botterillneurolab/StereoPylot/Build_Setup_Files/Wiring/PCB board schematic.pdf

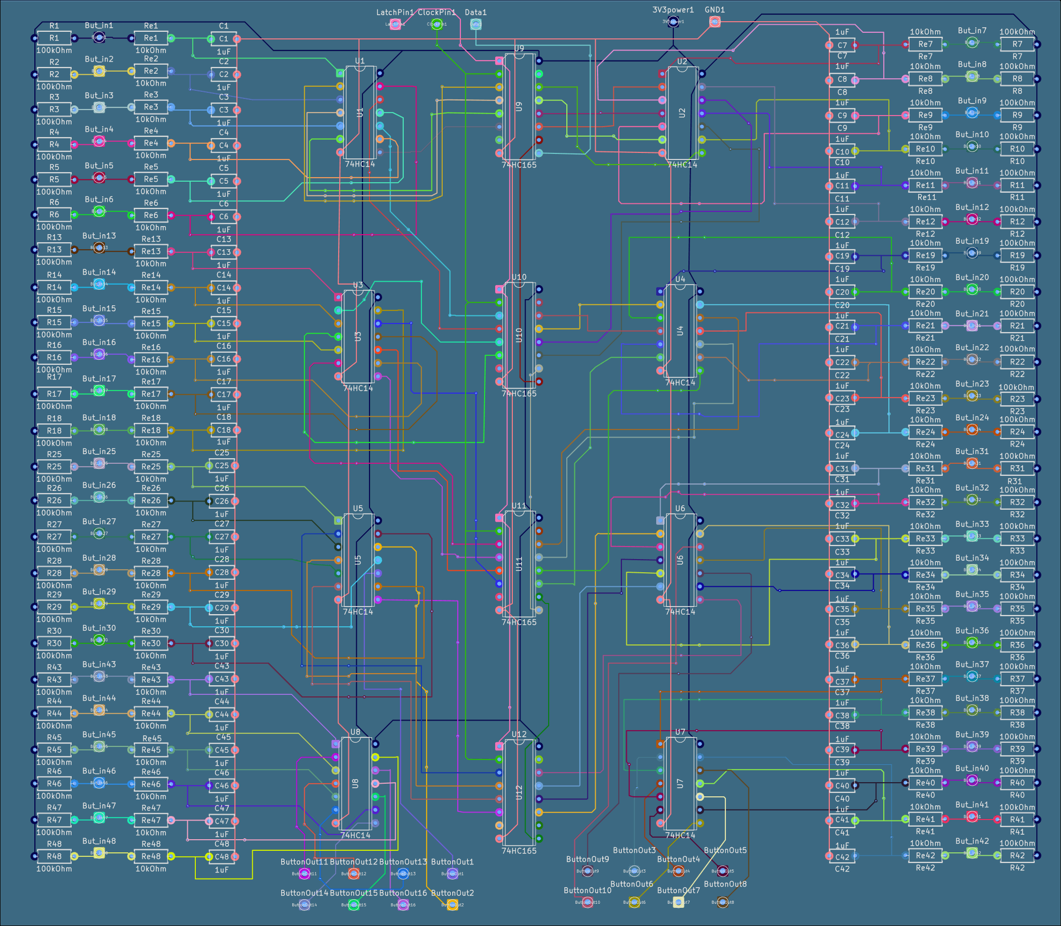
[picture p1: page 1]
