botterillneurolab/StereoPylot/Build_Setup_Files/3D_models/3d_Printing_STEP/37mm_Motor_Mount_Left.step

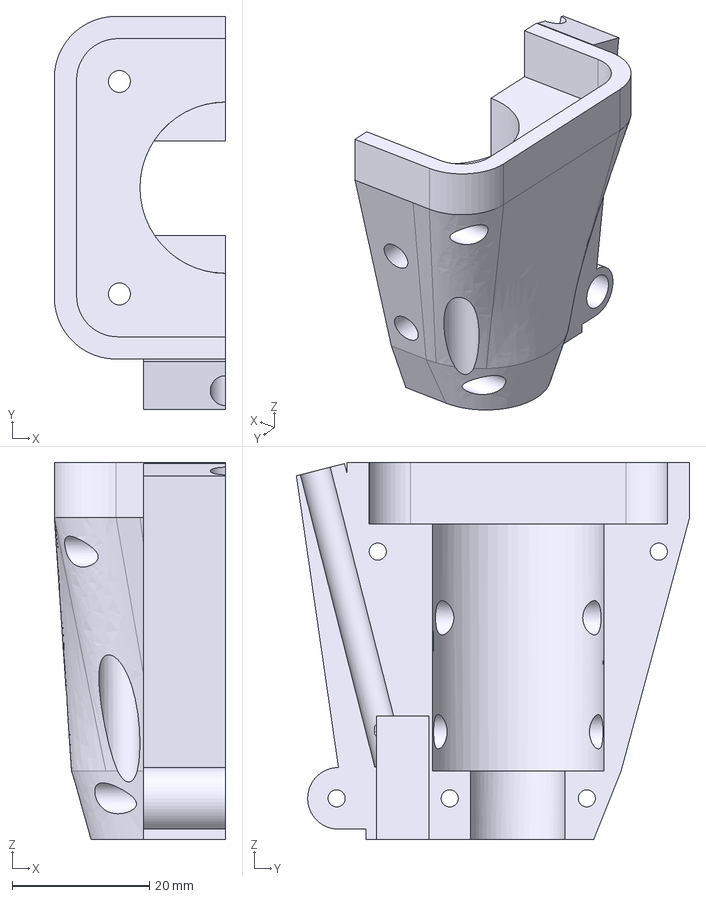
[picture p2: CAD file, 2026-03-18]
Build_Setup_Files/3D_models/3d_Printing_STEP/37mm_Motor_Mount_Left.step
25.0 x 57.4 x 55.0 mm
