botterillneurolab/StereoPylot/Build_Setup_Files/3D_models/3d_Printing_STEP/Control_Box_Upper_Face.step

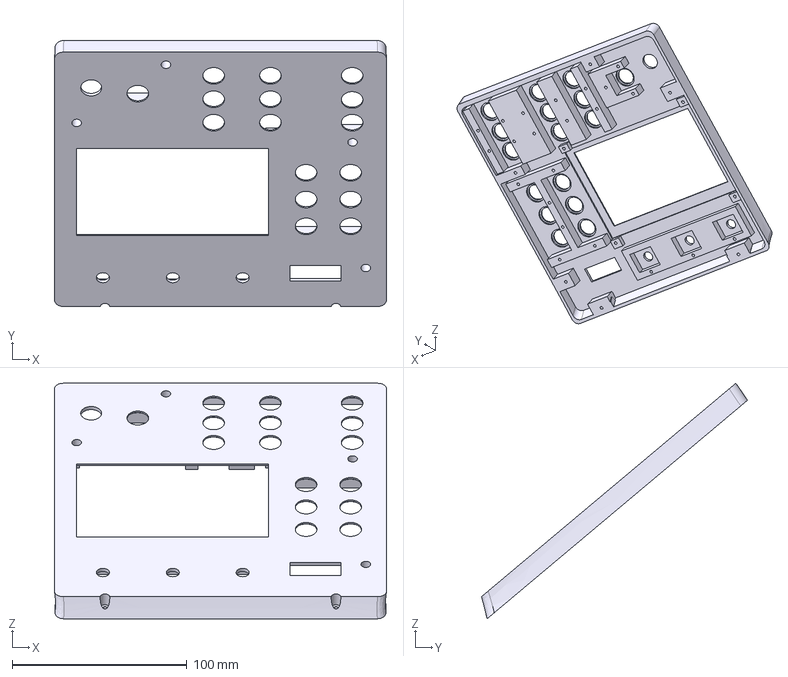
[picture p3: CAD file, 2026-03-18]
Build_Setup_Files/3D_models/3d_Printing_STEP/Control_Box_Upper_Face.step
190.0 x 152.2 x 134.8 mm
