botterillneurolab/StereoPylot/Build_Setup_Files/3D_models/3d_Printing_STEP/Control_Box_Cableholder.step

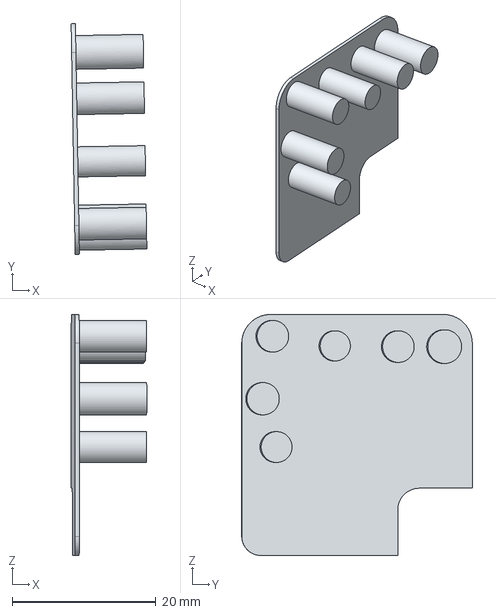
[picture p4: CAD file, 2026-03-18]
Build_Setup_Files/3D_models/3d_Printing_STEP/Control_Box_Cableholder.step
10.5 x 32.1 x 33.5 mm
