botterillneurolab/StereoPylot/Build_Setup_Files/3D_models/3d_Printing_STEP/Control_Box_Mid_Box.step

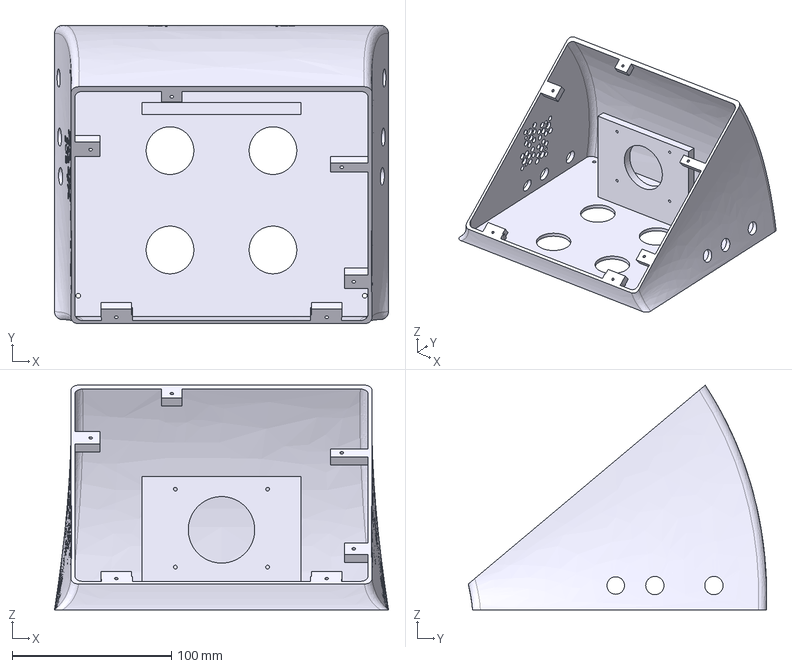
[picture p5: CAD file, 2026-03-18]
Build_Setup_Files/3D_models/3d_Printing_STEP/Control_Box_Mid_Box.step
210.0 x 187.6 x 141.3 mm
