botterillneurolab/StereoPylot/Build_Setup_Files/3D_models/3d_Printing_STEP/Control_Box_Lower_Box.step

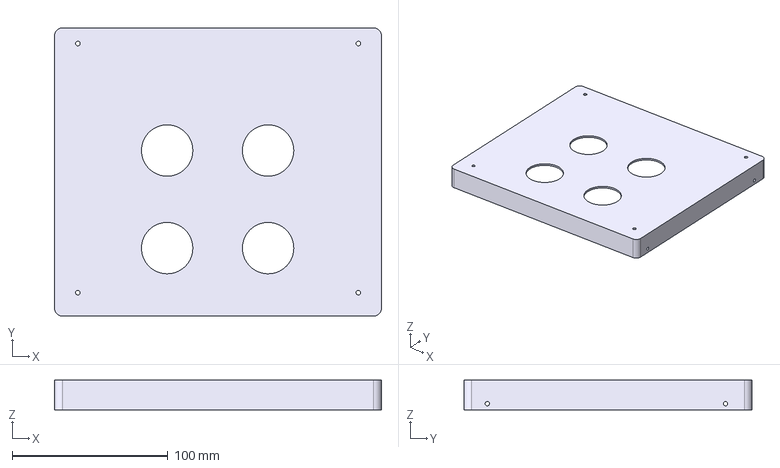
[picture p6: CAD file, 2026-03-18]
Build_Setup_Files/3D_models/3d_Printing_STEP/Control_Box_Lower_Box.step
210.0 x 185.0 x 19.0 mm
