botterillneurolab/StereoPylot/Build_Setup_Files/3D_models/3d_Printing_STEP/Control_Box_Base_Cover.step

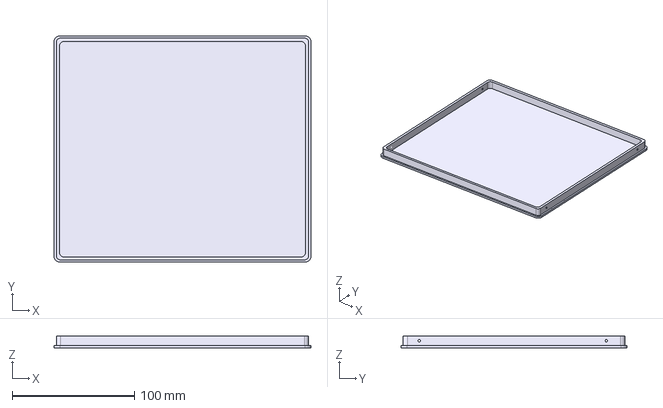
[picture p7: CAD file, 2026-03-18]
Build_Setup_Files/3D_models/3d_Printing_STEP/Control_Box_Base_Cover.step
210.0 x 185.0 x 10.0 mm
