botterillneurolab/StereoPylot/Build_Setup_Files/3D_models/3d_Printing_STEP/Motor_Mount_Rear.step

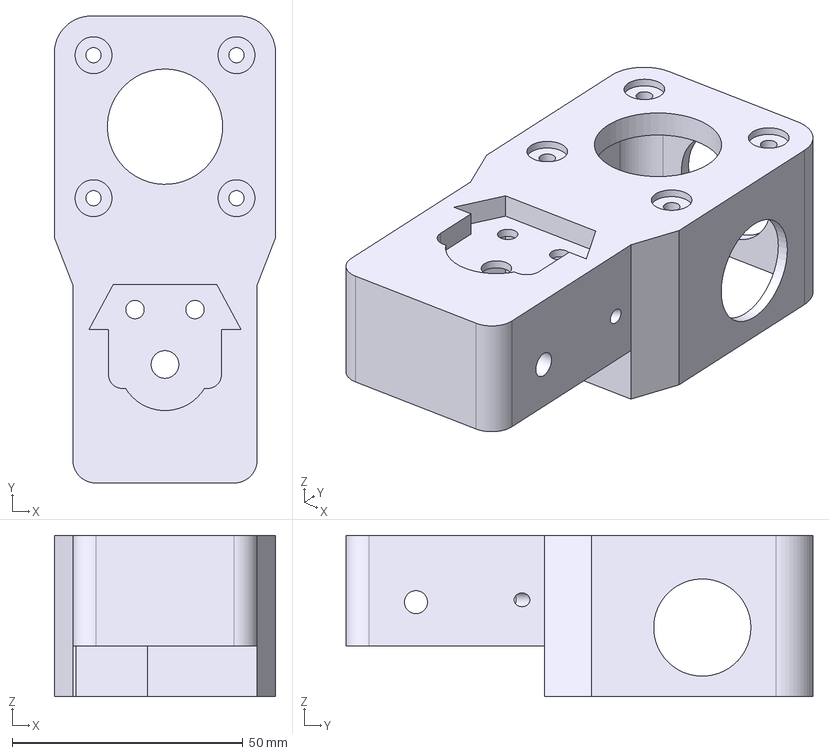
[picture p8: CAD file, 2026-03-18]
Build_Setup_Files/3D_models/3d_Printing_STEP/Motor_Mount_Rear.step
48.0 x 101.2 x 35.0 mm
