botterillneurolab/StereoPylot/Build_Setup_Files/3D_models/3d_Printing_STEP/Tapping_Guide.step

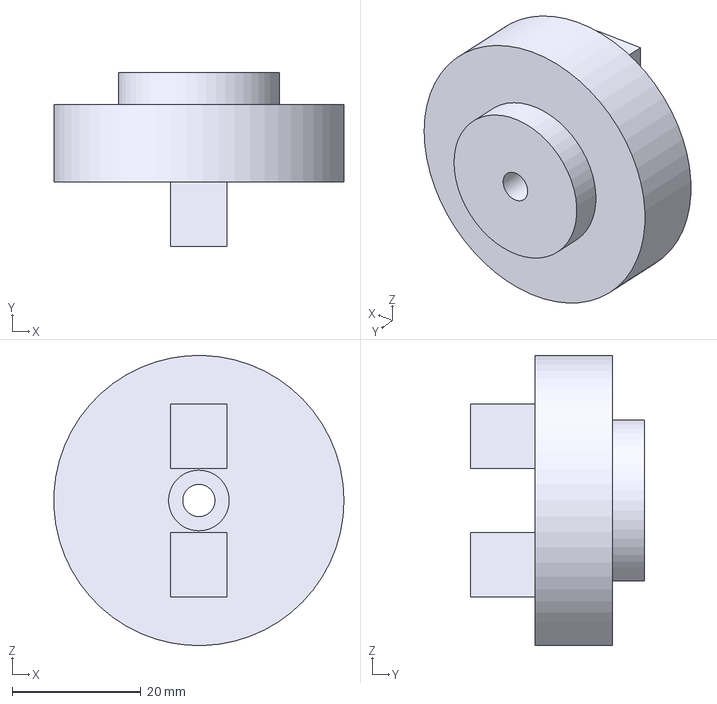
[picture p9: CAD file, 2025-12-02]
Build_Setup_Files/3D_models/3d_Printing_STEP/Tapping_Guide.step
45.0 x 27.0 x 45.0 mm
