botterillneurolab/StereoPylot/(list of files, cad)

Other CAD files:
Build_Setup_Files/3D_models/3d_Printing_STEP/33mm_Motor_Mount_Right.step
Build_Setup_Files/3D_models/3d_Printing_STEP/37mm_Motor_Mount_Right.step
Build_Setup_Files/3D_models/3d_Printing_STEP/33mm_Motor_Mount_Left.step
Build_Setup_Files/3D_models/3d_Printing_STEP/36mm_Motor_Mount_Left.step
Build_Setup_Files/3D_models/3d_Printing_STEP/36mm_Motor_Mount_Right.step
Build_Setup_Files/3D_models/3d_Printing_STEP/Control_Box_Face.step
Build_Setup_Files/3D_models/3d_Printing_STEP/Control_Box_lower.step
Build_Setup_Files/3D_models/3d_Printing_STLs/33mm_Motor_Mount_Left.stl
Build_Setup_Files/3D_models/3d_Printing_STLs/33mm_Motor_Mount_Right.stl
Build_Setup_Files/3D_models/3d_Printing_STLs/36mm_Motor_Mount_Left.stl
Build_Setup_Files/3D_models/3d_Printing_STLs/36mm_Motor_Mount_Right.stl
Build_Setup_Files/3D_models/3d_Printing_STLs/37mm_Motor_Mount_Left.stl
Build_Setup_Files/3D_models/3d_Printing_STLs/37mm_Motor_Mount_Right.stl
Build_Setup_Files/3D_models/3d_Printing_STLs/Control_Box_Base_Cover.stl
Build_Setup_Files/3D_models/3d_Printing_STLs/Control_Box_Cableholder.stl
Build_Setup_Files/3D_models/3d_Printing_STLs/Control_Box_Lower_Box.stl
Build_Setup_Files/3D_models/3d_Printing_STLs/Control_Box_Mid_Box.stl
Build_Setup_Files/3D_models/3d_Printing_STLs/Control_Box_Upper_Face.stl
Build_Setup_Files/3D_models/3d_Printing_STLs/Motor_Mount_Rear.stl
Build_Setup_Files/3D_models/3d_Printing_STLs/Tapping_Guide.stl
