botterillneurolab/StereoPylot/Build_Setup_Files/Button_Overlay/Button_Overlay.pdf

## Emergency

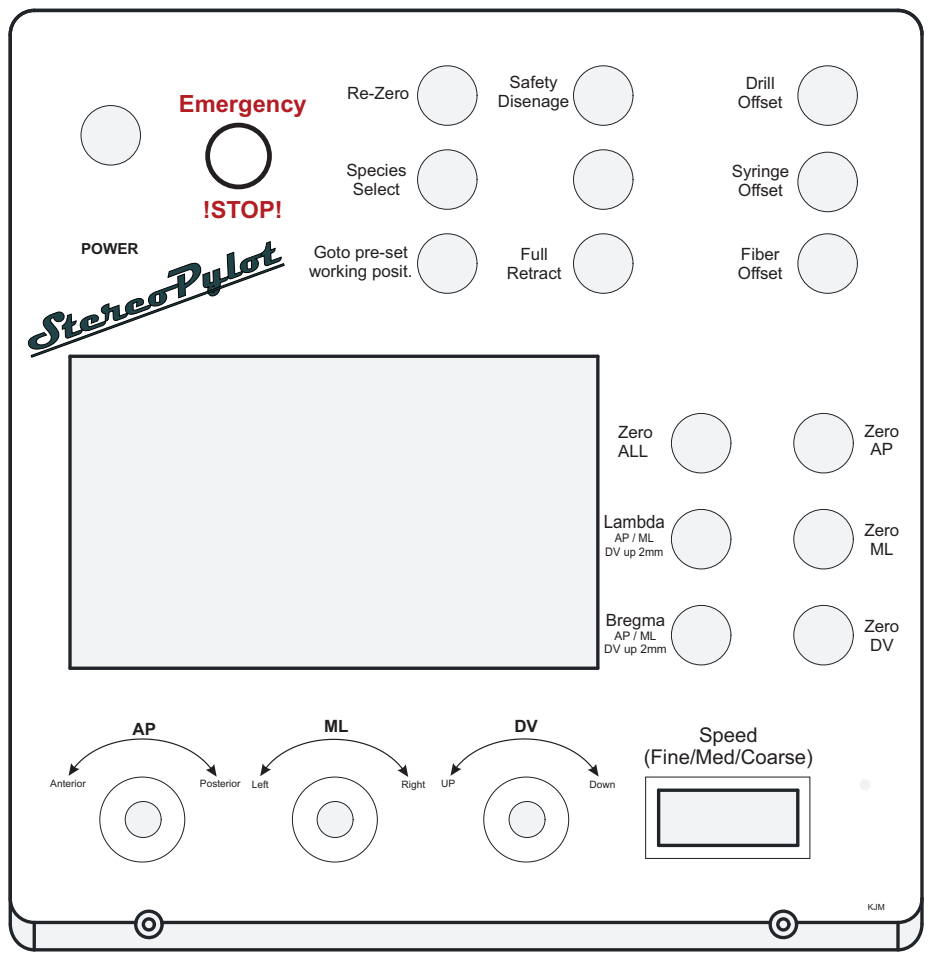
[picture p10: page 1]
!STOP!; Re-Zero; Full Retract; Drill Offset; Syringe Offset; Fiber Offset; Zero AP; Zero ML; Zero DV; Zero ALL; Bregma; Lambda; Left; Right; Anterior; Posterior; Down; Speed; KJM; Safety Disenage; Species Select; StereoPylot POWER

Goto pre-set
working posit.

(Fine/Med/Coarse)
