botterillneurolab/StereoPylot/Build_Setup_Files/Wiring/RaspberryPinLayout.xlsx

Raspberry PI Pin Layout
 | SD Card Slot
Connection | GPIO | Pin Number | Pin Number | GPIO | Connection
Button board / Encoder board | 3v3 | 1 | 2 | 5v | stepper 5V
Enable ALL | 2 | 3 | 4 | 5v
dir AP | 3 | 5 | 6 | GND | stepper GND
step AP | 4 | 7 | 8 | 14
 | GND | 9 | 10 | 15
dir ML | 17 | 11 | 12 | 18 | LatchPin
step ML | 27 | 13 | 14 | GND | Button board GND
limit AP | 22 | 15 | 16 | 23 | ClockPin
 | 3v3 | 17 | 18 | 24 | DataPin
misc_butA | 10 | 19 | 20 | GND | Limit GND
 | 9 | 21 | 22 | 25 | rotoAP_A
misc_butB | 11 | 23 | 24 | 8 | rotoAP_B
Button board GND | GND | 25 | 26 | 7
 | 0 | 27 | 28 | 1
dir DV | 5 | 29 | 30 | GND
step DV | 6 | 31 | 32 | 12 | rotoML_A
limit ML | 13 | 33 | 34 | GND
limit DV | 19 | 35 | 36 | 16 | rotoML_B
EMERG STOP | 26 | 37 | 38 | 20 | rotoDV_A
Encoder Board GND | GND | 39 | 40 | 21 | rotoDV_B
