botterillneurolab/StereoPylot/Build_Setup_Files/Wiring/Wiring Diagram.pdf

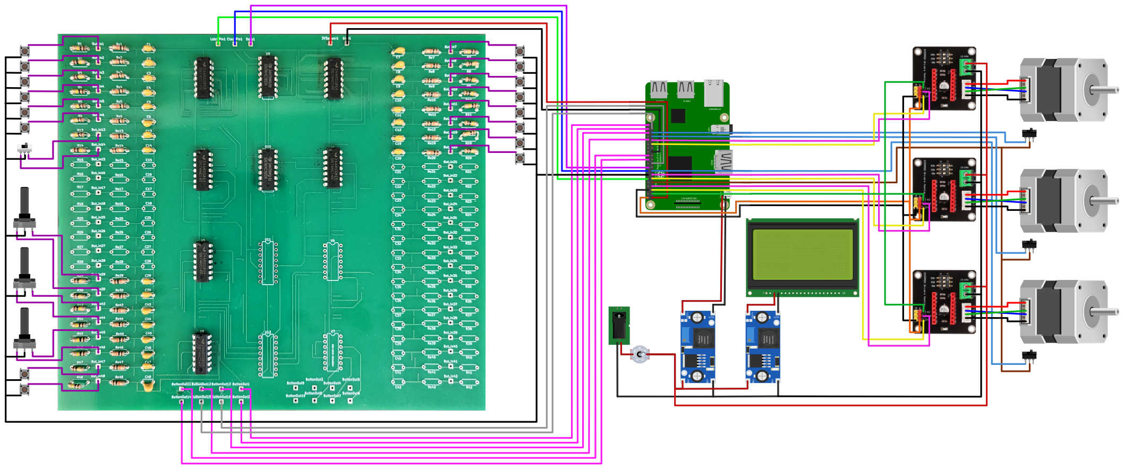
[picture p11: page 1]
