botterillneurolab/StereoPylot/(commit log)

2025-12-02 Initial upload of files
    [33mm_Motor_Mount_Left.step, 33mm_Motor_Mount_Left.stl, 33mm_Motor_Mount_Right.step, 33mm_Motor_Mount_Right.stl, 36mm_Motor_Mount_Left.step, 36mm_Motor_Mount_Left.stl, 36mm_Motor_Mount_Right.step, 36mm_Motor_Mount_Right.stl]
2025-12-08 Code fix
    Corrected direction movement difference between LH and RH sides.
    [StereotaxicUI.py]
2026-03-18 Delete Build_Setup_Files/3D_models/3d_Printing_STEP directory
    Deleting directory for restructuring
    [33mm_Motor_Mount_Left.step, 33mm_Motor_Mount_Right.step, 36mm_Motor_Mount_Left.step, 36mm_Motor_Mount_Right.step, 37mm_Motor_Mount_Left.step, 37mm_Motor_Mount_Right.step, Control_Box_Face.step, Control_Box_lower.step]
2026-03-18 Delete Build_Setup_Files/3D_models/3d_Printing_STLs directory
    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
    [33mm_Motor_Mount_Left.stl, 33mm_Motor_Mount_Right.stl, 36mm_Motor_Mount_Left.stl, 36mm_Motor_Mount_Right.stl, 37mm_Motor_Mount_Left.stl, 37mm_Motor_Mount_Right.stl, Control_Box_Face.stl, Motor_Mount_Rear.stl]
2026-03-18 Delete RightHand/Buttonclassv1-old.py
    Deleting files for restructuring
2026-03-18 Updating files
    [33mm_Motor_Mount_Left.step, 33mm_Motor_Mount_Left.stl, 33mm_Motor_Mount_Right.step, 33mm_Motor_Mount_Right.stl, 36mm_Motor_Mount_Left.step, 36mm_Motor_Mount_Left.stl, 36mm_Motor_Mount_Right.step, 36mm_Motor_Mount_Right.stl]
